hakansrc/EE463-Hardware-Project-team-FNAG/README.md

# EE463-Hardware-Project
Hardware project repository of team FNAG (Faz Nötr Al Götür) 

Project Video Link: https://youtu.be/eVu52fjexhE
