hakansrc/EE463-Hardware-Project-team-FNAG/test for rect.xlsx

IL = 4A | Dclink capacitor RMS current |  | Capacitor max current |  | Output Vpp value
cap value | L = 10uH | L = 100uH | L = 10uH | L = 100uH | L = 10uH | L = 100uH
C = 2200uF | 10.2A 156000V/sec | 6.5A 43000V/sec | 34.6A | 14.8A | 5.1V | 4.1V
C =1000uF | 10.9V 206000V/sec | 6.9A 45000V/sec | 41.65A | 16.5A | 11V | 9.4V
C = 680uF | 9A 195000V/sec | 7.2A 48000V/sec | 34.71A | 17.8A | 14.12V | 14.14V
