hakansrc/EE463-Hardware-Project-team-FNAG/mcu/version1/version1.ino

int pwm_value = 0;
int percentage = 0;
void setup() {
  pinMode(9,OUTPUT);
  digitalWrite(9,LOW);
  setPwmFrequency(9,1);
  Serial.begin(115200);
  pinMode(10,OUTPUT);
  digitalWrite(10,LOW);
  setPwmFrequency(10,1);

}

void loop() {
//  for(int i=0,;i>255

  //delay(500);
  pwm_value = analogRead(A0);
  percentage = map(pwm_value,0,1023,13,242);
  Serial.print(percentage); 
  Serial.print('\n');
 // delay(100);
  analogWrite(9,percentage);
  analogWrite(10,percentage);

}
void setPwmFrequency(int pin, int divisor) {
  byte mode;
  if(pin == 5 || pin == 6 || pin == 9 || pin == 10) {
    switch(divisor) {
      case 1: mode = 0x01; break;
      case 8: mode = 0x02; break;
      case 64: mode = 0x03; break;
      case 256: mode = 0x04; break;
      case 1024: mode = 0x05; break;
      default: return;
    }
    if(pin == 5 || pin == 6) {
      TCCR0B = TCCR0B & 0b11111000 | mode;
    } else {
        TCCR1B = TCCR1B & 0b11111000 | mode;
    }
  } else if(pin == 3 || pin == 11) {
    switch(divisor) {
      case 1: mode = 0x01; break;
      case 8: mode = 0x02; break;
      case 32: mode = 0x03; break;
      case 64: mode = 0x04; break;
      case 128: mode = 0x05; break;
      case 256: mode = 0x06; break;
      case 1024: mode = 0x7; break;
      default: return;
    }
    TCCR2B = TCCR2B & 0b11111000 | mode;
  }
}
