hakansrc/EE463-Hardware-Project-team-FNAG/(commit log)

2017-12-10 first step on simulations
    [Comparison of topologies.xlsx]
2018-01-02 some value updates
    [degerler.xlsx]
2018-01-22 pwm trials
